thephantom8768/Phantom-Macro-Mk.1/README.md

# Phantom Macro Mk.1 Series

> A modular, snap-together macropad ecosystem with lateral pogo-pin bus interconnects.

Chain modules side-by-side to expand your desktop workflow—from a compact macro-pad into a full fledge keyboard.

---

## 📌 Project Status

- **Hardware:** Series still in-dev
- **Firmware:** In active development.
- **Interconnect:** Custom edge-mount 8 pin pogo interface.

---

## ⚡ Features

- **Snap & Chain Topology:** Expand your layout horizontally by mating adjacent modules using edge-mounted pogo connectors.
- **Unified Bus Standard:** Standardized power, ground, and communication rails allow any Mk.1-series compatible module to hot-mate with the system.
- **Flexible Layouts:** Mix and match different form factors (numpads, macro clusters, encoder dials) without rerunning separate USB cables to your host machine.

## ⚠️ Build Warnings

> **DIY Soldering Required:** This is a fully self-assembled project. It is not a plug-and-play kit and requires intermediate soldering experience.

* **Double-Sided Assembly:** Depending on the macro-pad, components might need to be soldered onto **both the top and bottom** of the PCB.

## *Mk.1 Series*

<details>
  <summary><b>🔢 Phantom-Macro-Mk.1 Pad (click here)</b></summary>
  
  ### Macro Mk.1 Pad
  
  #### Schematic

<table>
  <tr>
    <td colspan="4">
      Phantom Macro Mk1 Pad Schematic
    </td>
  </tr>
</table>

#### PCB Layout

4 Layers PCB
| Front (1st layer)|Back (4th layer) |
| ----- | ----- |
|  |  |

#### PCB
| Front | Back |
| ----- | ---- |
|  |  |
|  |  |

#### Case



</details>

<details>
  <summary><b>🎹 Phantom-Macro-Mk.1 MIDI (click here)</b></summary>
  
  ### Macro Mk.1 MIDI
  
  #### Schematic

  Phantom Macro Mk.1 MIDI

  ### PCB Layout 

  2 Layers PCB
  | Front | Back |
  | ----- | ----- |
  |  |  |

  #### PCB
  | Front | Back |
  | ----- | ---- |
  |  |  |
  |  |  |

</details>
