thephantom8768/Phantom-Macro-Mk.1/BOM.md

# Phantom Macro Mk.1 – bill of materials

<!-- Generated by Half Life from project cmuwyl8mx002001rlbmdwee1s. Edits here are overwritten on the next sync. -->
<!-- Generated: 2026-10-12T13:11:29.447Z -->

> [!NOTE]
> This parts list is mirrored from [Half Life](https://halflife.hackclub.com). Editing it here will not change the platform's copy, and the next sync overwrites this file.

| Week | Tier | Parts funding |
| --- | --- | --- |
| Week 1 | Tier 2 | $65.00 |

| Part | What it's for | Qty | Unit | Total | Vendor |
| --- | --- | --- | --- | --- | --- |
| [1uF](https://jlcpcb.com/partdetail/CL05A105KO5NNNC/C29266) | Capacitor | 20 | $0.01 | $0.20 | [JLCPCB](https://jlcpcb.com/partdetail/CL05A105KO5NNNC/C29266) |
| [15pF](https://jlcpcb.com/partdetail/KEMET-C0402C150J4GACTU/C2168202) | Capacitor | 3 | $0.01 | $0.03 | [JLCPCB](https://jlcpcb.com/partdetail/KEMET-C0402C150J4GACTU/C2168202) |
| [100nF](https://jlcpcb.com/partdetail/0402B104K250NT/C56392) | Capacitor | 9 | $0.01 | $0.09 | [JLCPCB](https://jlcpcb.com/partdetail/0402B104K250NT/C56392) |
| [USBLC6-2SC6](https://intl.taobao.com/sk/_b.rc54cg) | Protection | 1 | $0.02 | $0.02 | [Taobao](https://intl.taobao.com/sk/_b.rc54cg) |
| [PMEG3030EP](https://click.world.taobao.com/_b.Hc53SX 「A5 Silk Screen A5 Pmeg3030Ep Smd Sod-128 Schottky Diode Original in Stock Available for Direct Purchase」 Tap and open Taobao to view) | Diode | 1 | $0.01 | $0.01 | [Taobao](https://click.world.taobao.com/_b.Hc53SX 「A5 Silk Screen A5 Pmeg3030Ep Smd Sod-128 Schottky Diode Original in Stock Available for Direct Purchase」 Tap and open Taobao to view) |
| [USB_C_Receptacle_USB2.0_16P](https://intl.taobao.com/sk/_b.zc53Cc 「10 Pieces) Ul26 Ul46 Smd Sot23-6 Esd Electrostatic Protection Component Usblc6-2Sc6/4Sc6」 Tap and open Taobao to view) | USB C | 1 | $0.03 | $0.03 | [Taobao](https://intl.taobao.com/sk/_b.zc53Cc 「10 Pieces) Ul26 Ul46 Smd Sot23-6 Esd Electrostatic Protection Component Usblc6-2Sc6/4Sc6」 Tap and open Taobao to view) |
| [01x08 pogo](https://intl.taobao.com/sk/_b.oc53e2) | Connect other macropads | 1 | $1.64 | $1.64 | [Taobao](https://intl.taobao.com/sk/_b.oc53e2) |
| [SK6803MINI-E-001](https://intl.taobao.com/sk/_b.Rc54Br781-83e92ad56c50&pdp_ext_f=%7B%22order%22%3A%2264%22%2C%22eval%22%3A%221%22%2C%22fromPage%22%3A%22search%22%7D&utparam-url=scene%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) | RGB | 16 | $0.05 | $0.80 | [Taobao](https://intl.taobao.com/sk/_b.Rc54Br781-83e92ad56c50&pdp_ext_f=%7B%22order%22%3A%2264%22%2C%22eval%22%3A%221%22%2C%22fromPage%22%3A%22search%22%7D&utparam-url=scene%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) |
| [2N7002 7002 (per lot)](https://intl.taobao.com/sk/_b.Mc53Sz) | MOSFET | 1 | $0.27 | $0.27 | [Taobao](https://intl.taobao.com/sk/_b.Mc53Sz) |
| [5.1k](https://jlcpcb.com) | Resistor | 2 | $0.01 | $0.02 | [JLCPCB](https://jlcpcb.com) |
| [1k](https://jlcpcb.com) | Res | 1 | $0.01 | $0.01 | [JLCPCB](https://jlcpcb.com) |
| [10k](https://jlcpcb.com) | Resistor | 2 | $0.01 | $0.02 | [JLCPCB](https://jlcpcb.com) |
| [120R](https://jlcpcb.com) | Resistor | 2 | $0.01 | $0.02 | [JLCPCB](https://jlcpcb.com) |
| [PEC11R-4020F-S0024](https://intl.taobao.com/sk/_b.Rc53Te) | Rotary encoder | 1 | $3.49 | $3.49 | [Taobao](https://intl.taobao.com/sk/_b.Rc53Te) |
| [ABM8-272-T3_C20625731](https://intl.taobao.com/sk/_b.Pc54b5) | Crystal clock | 1 | $0.07 | $0.07 | [Taobao](https://intl.taobao.com/sk/_b.Pc54b5) |
| [CD74HC4067SM96](https://intl.taobao.com/sk/_b.Cc540g) | Multiplexer | 2 | $0.43 | $0.86 | [Taobao](https://intl.taobao.com/sk/_b.Cc540g) |
| [SW_MX_HE (per lot)](https://milktooth.com/products/dove-he) | Haimu Dove HE v2 switches | 2 | $6.79 | $13.58 | [Milktooth](https://milktooth.com/products/dove-he) |
| [RP2040](https://intl.taobao.com/sk/_b.Ec533r) | MCU | 1 | $0.40 | $0.40 | [Taobao](https://intl.taobao.com/sk/_b.Ec533r) |
| [PCA9615DPZ / PCA9614DPZ](https://intl.taobao.com/sk/_b.Tc53GCam-url=scene%3Asearch%7Cquery_from%3A%7Cx_object_id%3A1005010726241692%7C_p_origin_prod%3A) | dI2c | 2 | $2.32 | $4.64 | [Taobao](https://intl.taobao.com/sk/_b.Tc53GCam-url=scene%3Asearch%7Cquery_from%3A%7Cx_object_id%3A1005010726241692%7C_p_origin_prod%3A) |
| [AP2112K-3.3TRG1](https://intl.taobao.com/sk/_b.uc542n) | 3V3 | 1 | $0.04 | $0.04 | [Taobao](https://intl.taobao.com/sk/_b.uc542n) |
| [W25Q128JVSIQ](https://intl.taobao.com/sk/_b.0c54pc6-7a44a45a75ad&pdp_ext_f=%7B%22order%22%3A%22-1%22%2C%22eval%22%3A%221%22%2C%22fromPage%22%3A%22search%22%7D&utparam-url=scene%3A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) | RP2040 Flash | 1 | $0.47 | $0.47 | [Taobao](https://intl.taobao.com/sk/_b.0c54pc6-7a44a45a75ad&pdp_ext_f=%7B%22order%22%3A%22-1%22%2C%22eval%22%3A%221%22%2C%22fromPage%22%3A%22search%22%7D&utparam-url=scene%3A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) |
| [PCB](https://jlcpcb.com) | Pcb | 1 | $31.10 | $31.10 | [JLCPCB](https://jlcpcb.com) |
| [DRV5055A3QDBZR (10 per lot)](https://intl.taobao.com/sk/_b.Qc5rRz) | Hall effect sensor | 2 | $3.10 | $6.20 | [Taobao](https://intl.taobao.com/sk/_b.Qc5rRz) |
| **Parts subtotal** | — | — | — | **$64.01** | — |
| **Tax & shipping** | — | — | — | **$0.00** | — |
| **Total** | — | — | — | **$64.01** | — |

$0.99 left of the tier's funding.
