thephantom8768/Phantom-Macro-Mk.1/BOM.csv

Reference | Qty | Value | DNP | Exclude from BOM | Exclude from Board | Footprint | Datasheet
C1,C2,C6,C7,C17,C18,C19,C21,C22,C23,C24,C25,C26,C27,C28,C29,C30,C31,C32,C33 | 20 | 1uF |  |  |  | Capacitor_SMD:C_0603_1608Metric_Pad1.08x0.95mm_HandSolder
C3,C4,C5 | 3 | 15pF |  |  |  | Capacitor_SMD:C_0402_1005Metric_Pad0.74x0.62mm_HandSolder
C8,C9,C10,C11,C12,C13,C14,C15,C16 | 9 | 100nF |  |  |  | Capacitor_SMD:C_0402_1005Metric_Pad0.74x0.62mm_HandSolder
D1 | 1 | USBLC6-2SC6 |  |  |  | PCM_Package_TO_SOT_SMD_AKL:SOT-23-6 | https://www.tme.eu/Document/db59d28d28a96c34f26d05f234ff409c/USBLC6-2.pdf
D2 | 1 | PMEG3030EP |  |  |  | PCM_Diode_SMD_AKL:D_SOD-128 | https://www.tme.eu/Document/abe71b1e3ae43c8e032df0d278a6f86a/PMEG3030EP.115.pdf
J1 | 1 | USB_C_Receptacle_USB2.0_16P |  |  |  | Connector_USB:USB_C_Receptacle_GCT_USB4110 | https://www.usb.org/sites/default/files/documents/usb_type-c.zip
J2 | 1 | Conn_01x02 |  |  |  | Connector_PinSocket_2.54mm:PinSocket_1x02_P2.54mm_Vertical
J4,J5 | 2 | Conn_01x08 |  |  |  | Connector_PinHeader_2.54mm:PinHeader_1x08_P2.54mm_Horizontal
LED1,LED2,LED3,LED5,LED6,LED7,LED8,LED9,LED10,LED11,LED12,LED13,LED14,LED15,LED16,LED17 | 16 | SK6803MINI-E-001 |  |  |  | lcsc_shared_footprints:C5242955_LED-SMD_4P-L3_2-W2_8_SK6803MINI-E-001 | https://wmsc.lcsc.com/wmsc/upload/file/pdf/v2/lcsc/2211011500_OPSCO-Optoelectronics-SK6803MINI-E-001_C5242955.pdf
Q1,Q2 | 2 | 2N7002 7002 |  |  |  | lcsc_shared_footprints:C8545_SOT-23-3_L2_9-W1_3-P1_90-LS2_4-BR | https://www.lcsc.com/datasheet/lcsc_datasheet_2304140030_Jiangsu-Changjing-Electronics-Technology-Co---Ltd--2N7002_C8545.pdf
R1,R2 | 2 | 5.1k |  |  |  | Resistor_SMD:R_0402_1005Metric_Pad0.72x0.64mm_HandSolder
R3 | 1 | 1k |  |  |  | Resistor_SMD:R_0402_1005Metric_Pad0.72x0.64mm_HandSolder
R4,R5 | 2 | 10k |  |  |  | Resistor_SMD:R_0402_1005Metric_Pad0.72x0.64mm_HandSolder
R6,R7 | 2 | 120R |  |  |  | Resistor_SMD:R_0402_1005Metric_Pad0.72x0.64mm_HandSolder
SW1 | 1 | PEC11R-4020F-S0024 |  |  |  | lcsc_shared_footprints:C143788_SW-TH_5P-L12_5-W13_4-P2_50-LS14_5 | https://www.lcsc.com/datasheet/lcsc_datasheet_2304140030_BOURNS-PEC11R-4020F-S0024_C143788.pdf
U1 | 1 | ABM8-272-T3_C20625731 |  |  |  | lcsc_shared_footprints:C20625731_CRYSTAL-SMD_4P-L3_2-W2_5-BL | https://www.lcsc.com/datasheet/lcsc_datasheet_2410121909_Abracon-LLC-ABM8-272-T3_C20625731.pdf
U2,U22 | 2 | CD74HC4067SM96 |  |  |  | lcsc_shared_footprints:C98457_SSOP-24_L8_1-W5_3-P0_65-LS7_8-BL | https://www.lcsc.com/datasheet/lcsc_datasheet_1810010611_Texas-Instruments-CD74HC4067SM96_C98457.pdf
U3,U4,U5,U7,U8,U9,U10,U11,U12,U13,U14,U15,U16,U17,U18,U19 | 16 | SW_MX_HE |  |  |  | PCM_marbastlib-he:Haimu Dove H V2 | https://wmsc.lcsc.com/wmsc/upload/file/pdf/v2/lcsc/2310271810_Hallwee-HAL9303SO_C19089525.pdf
U6 | 1 | RP2040 |  |  |  | lcsc_shared_footprints:C2040_LQFN-56_L7_0-W7_0-P0_4-EP | https://www.lcsc.com/datasheet/lcsc_datasheet_2201101600_Raspberry-Pi-RP2040_C2040.pdf
U20,U23 | 2 | PCA9615DPZ |  |  |  | lcsc_shared_footprints:C3824272_TSSOP-10_L3_0-W3_0-P0_50-LS4_9-BL | https://wmsc.lcsc.com/wmsc/upload/file/pdf/v2/lcsc/2407081642_NXP-Semicon-PCA9615DPZ_C3824272.pdf
U21 | 1 | AP2112K-3.3TRG1 |  |  |  | lcsc_shared_footprints:C51118_SOT-25-5_L2_9-W1_6-P0_95-LS2_8-BL | https://www.lcsc.com/datasheet/lcsc_datasheet_2304140030_Diodes-Incorporated-AP2112K-3-3TRG1_C51118.pdf
U25 | 1 | W25Q128JVSIQ |  |  |  | lcsc_shared_footprints:C113767_SOIC-8_L5_3-W5_3-P1_27-LS8_0-BL | https://www.lcsc.com/datasheet/lcsc_datasheet_1912111437_Winbond-Elec-W25Q128JVSIQ_C113767.pdf
