thephantom8768/Phantom-Macro-Mk.1/3D Case and Freecad File/Phantom Macro Mk1 Pad.step

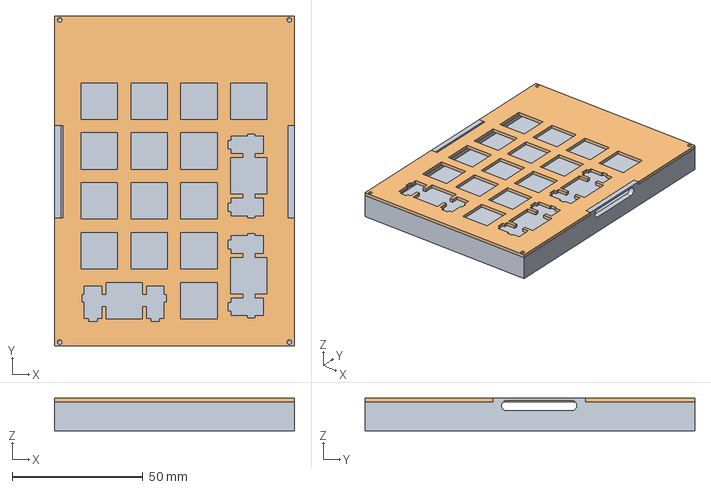
[picture p1: CAD file, 2026-10-19]
3D Case and Freecad File/Phantom Macro Mk1 Pad.step
91.7 x 126.1 x 12.5 mm
Mounting_plate
