thephantom8768/Phantom-Macro-Mk.1/(list of files, cad)

Other CAD files:
3D Case and Freecad File/Phantom Macro Mk1 Pad.FCStd
3D Case and Freecad File/Phantom Macro Mk1 Pad.stl
