thephantom8768/Phantom-Macro-Mk.1/Phantom Macro Mk1 Pad Kicad source file/Kicad file/Phantom Macro Mk1 Pad.kicad_pcb

## KiCad design Phantom Macro Mk1 Pad Kicad source file/Kicad file/Phantom Macro Mk1 Pad.kicad_pcb (2026-10-16)

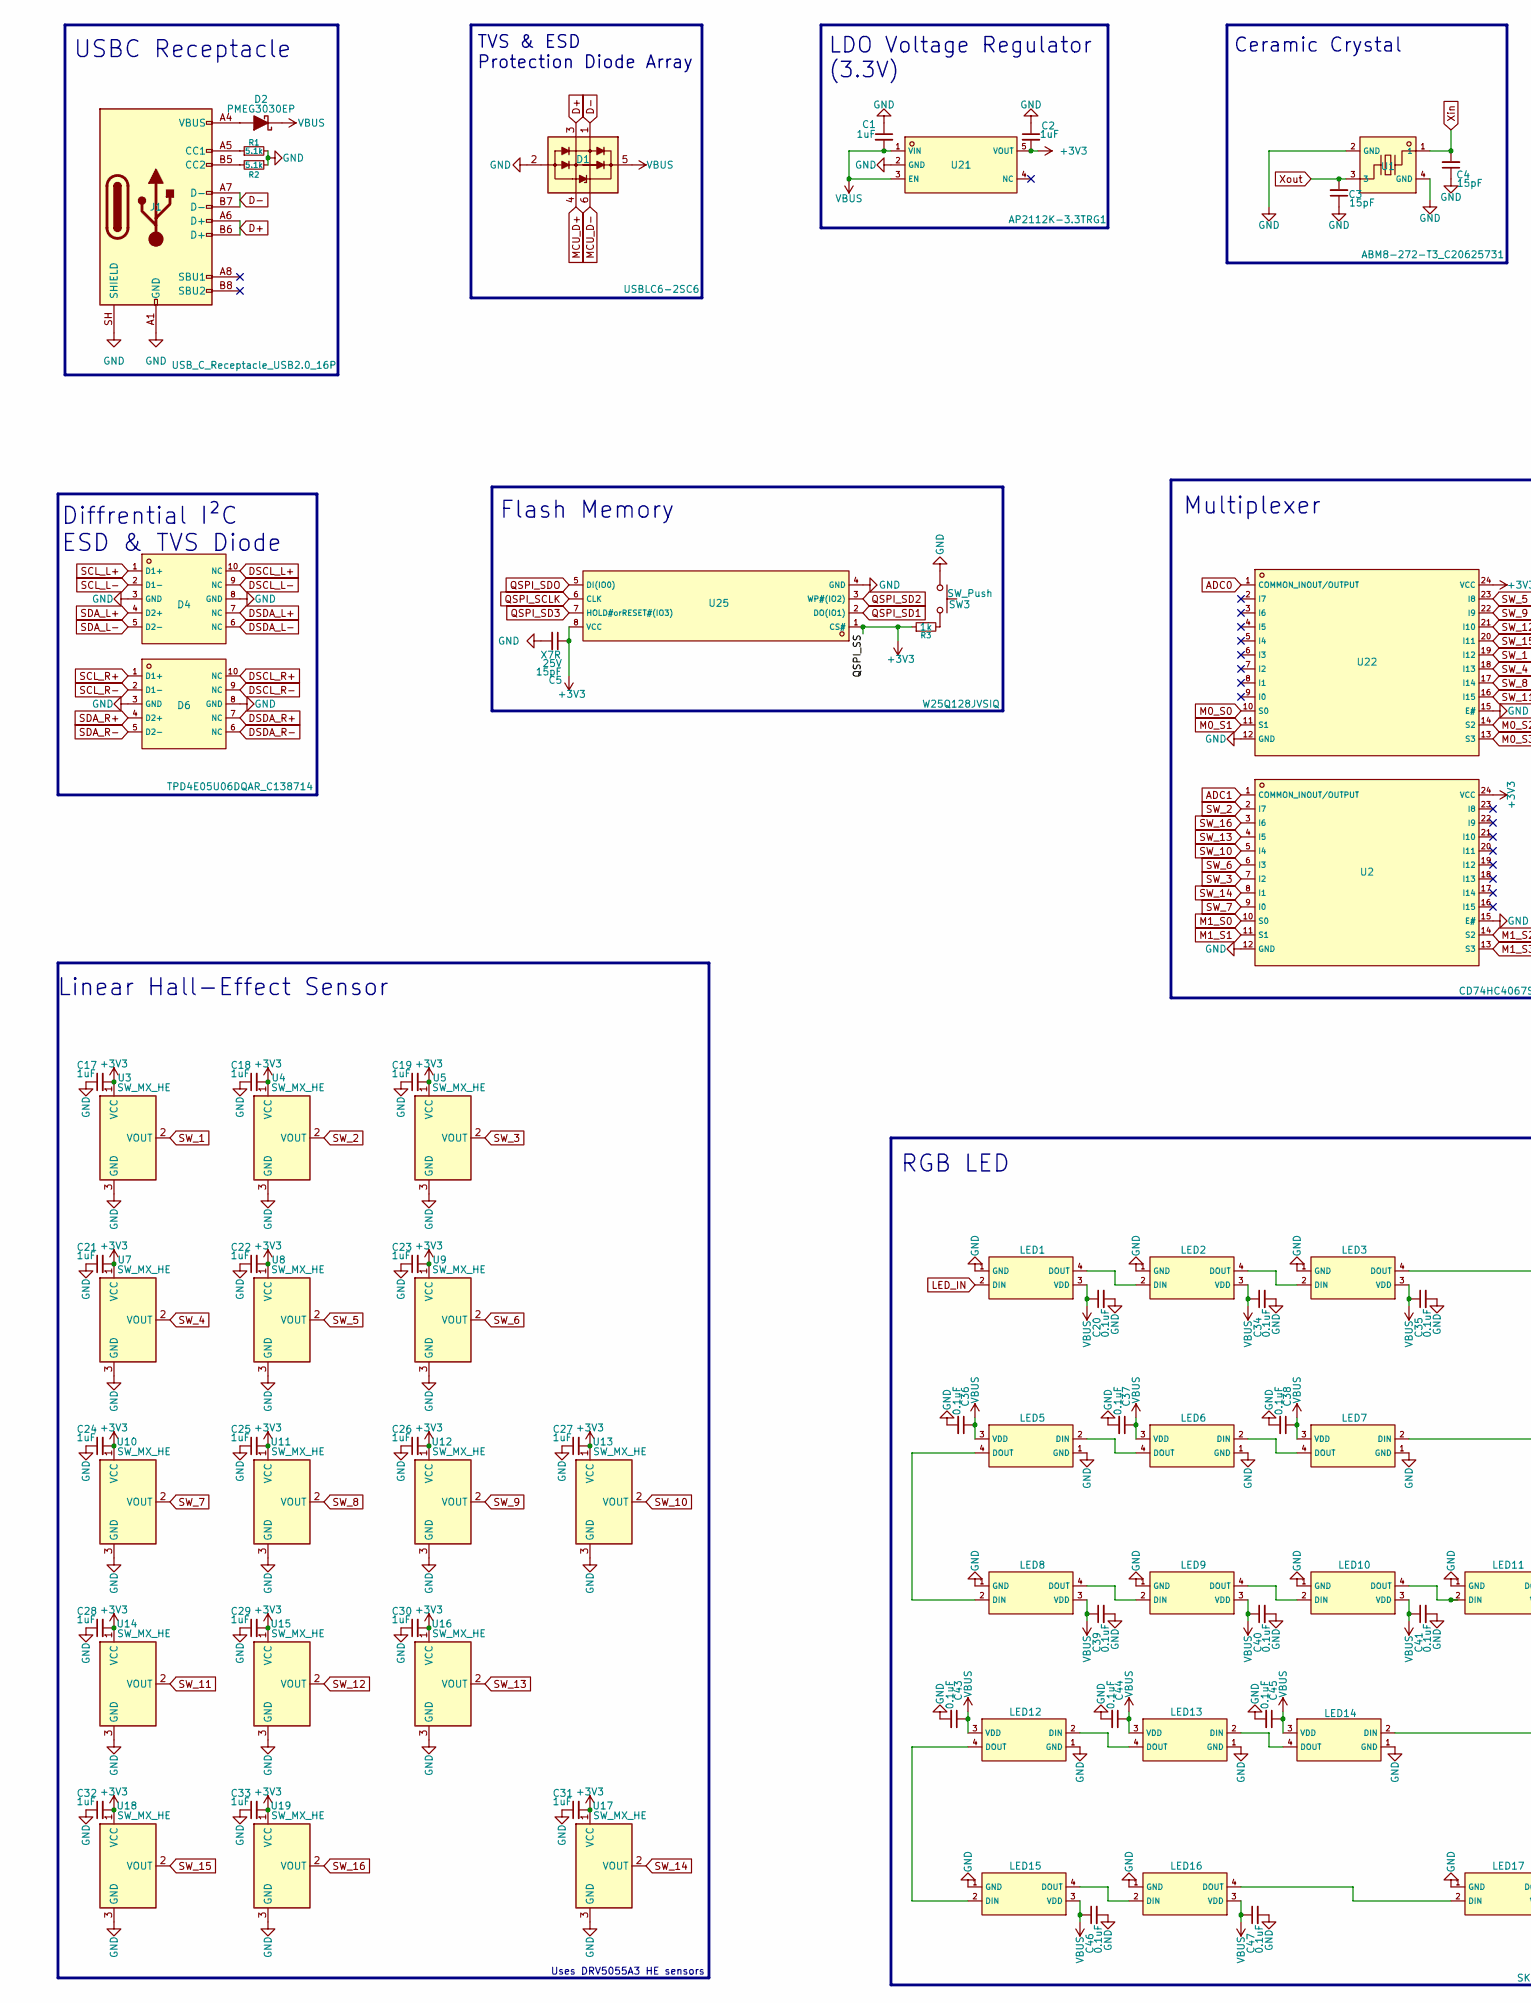
[picture p2: schematic Phantom Macro Mk1 Pad.kicad_sch, part in row 1, column 1]

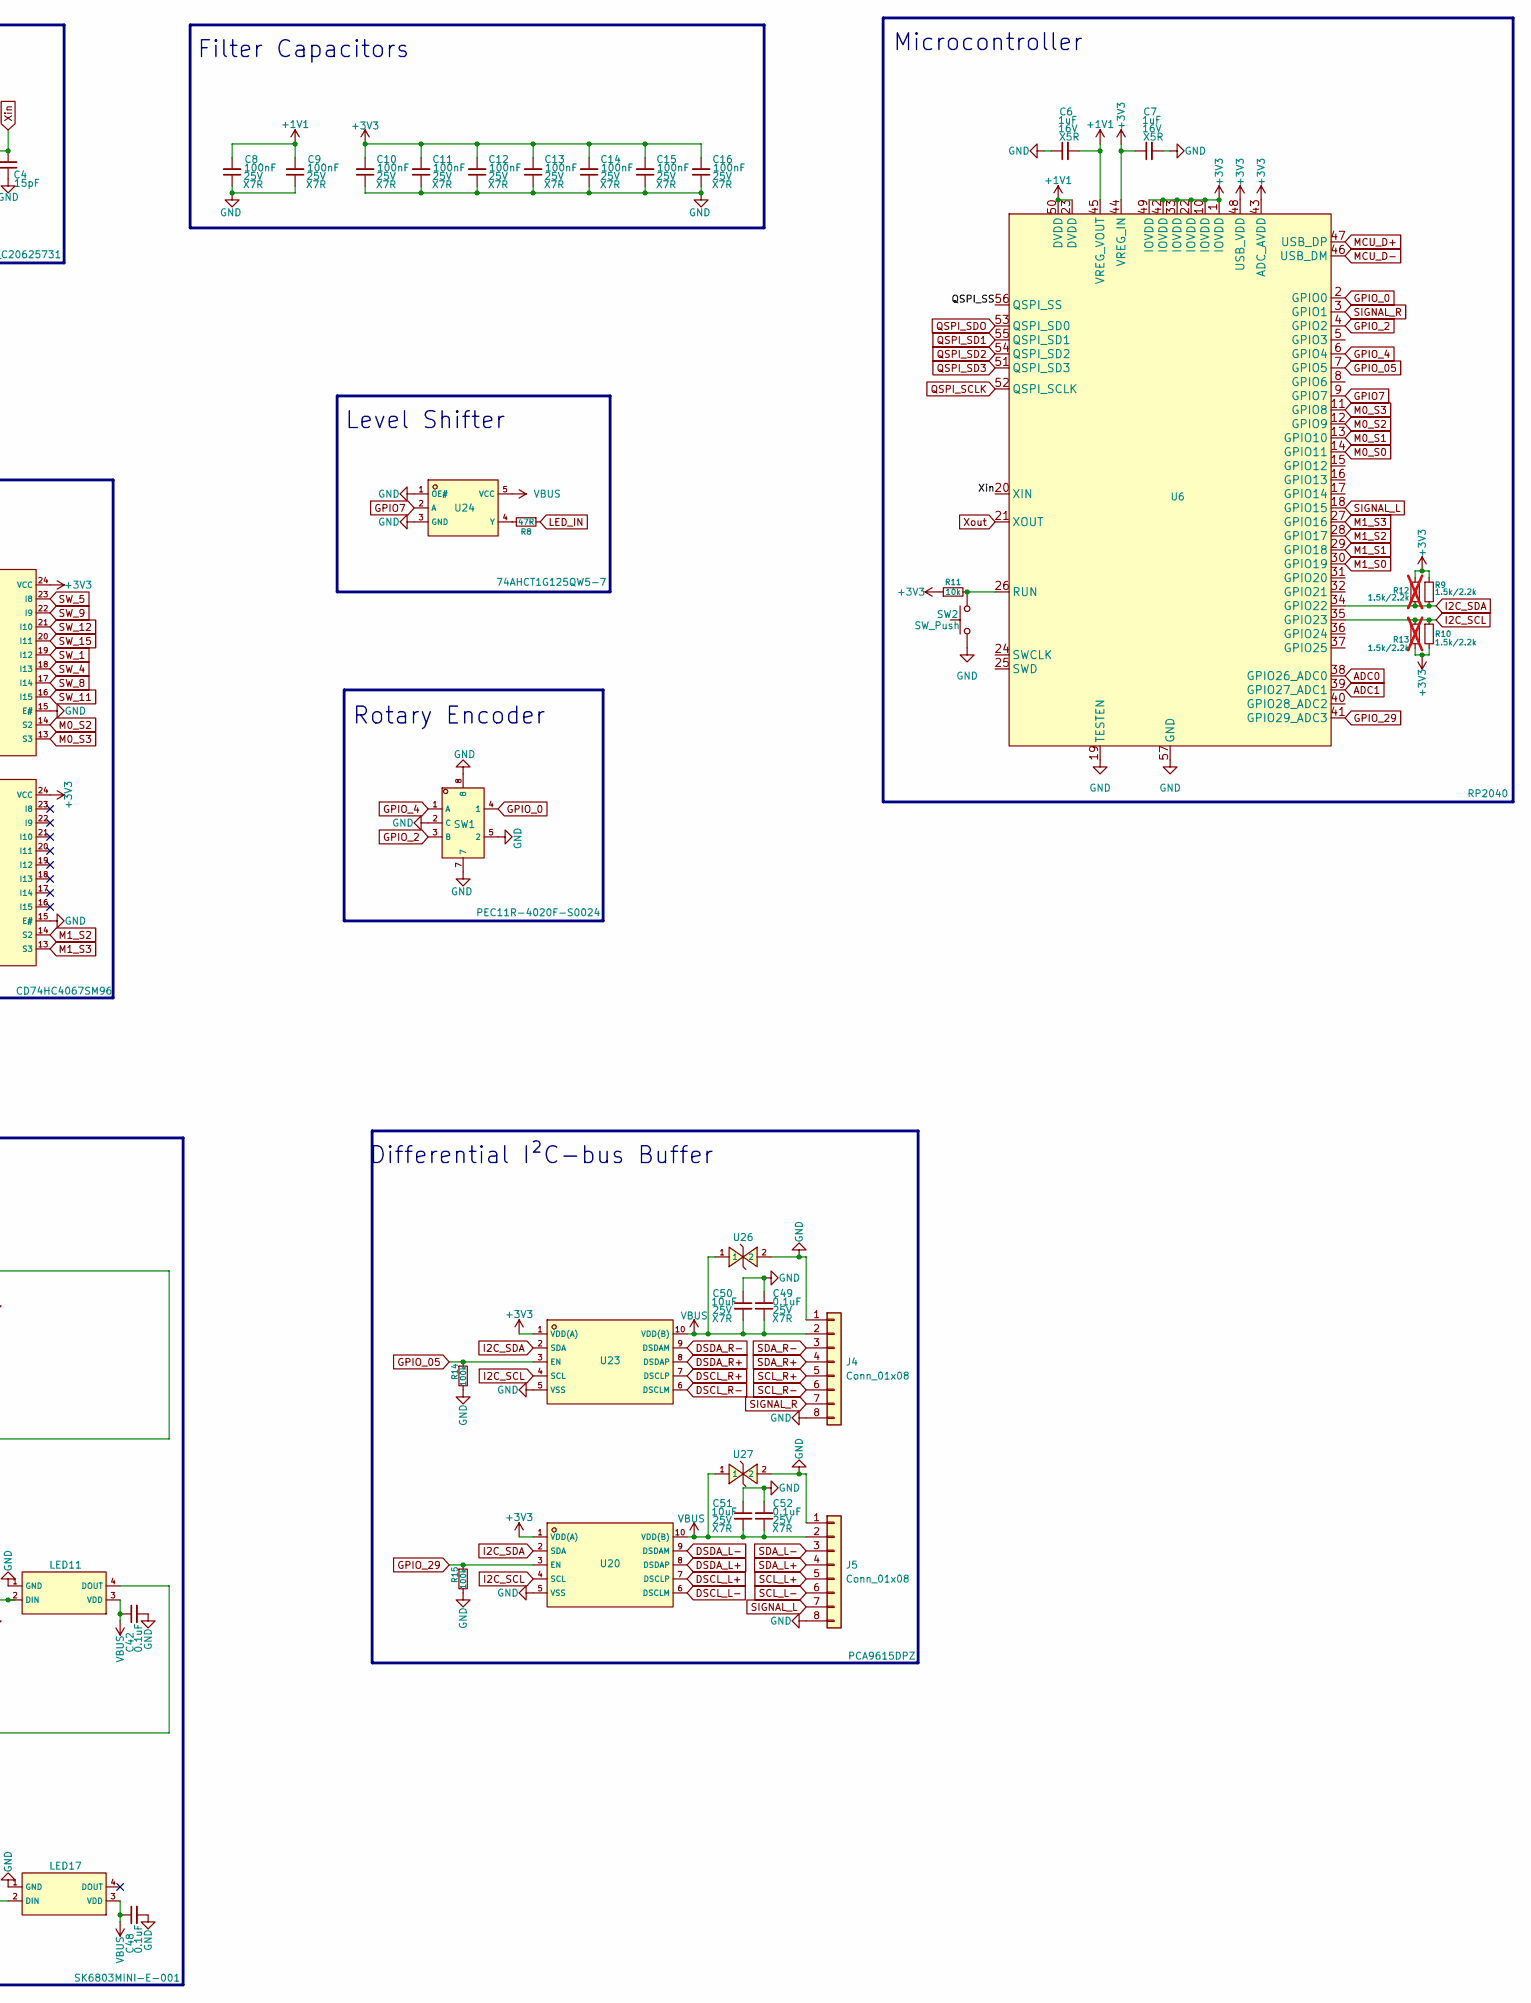
[picture p3: schematic Phantom Macro Mk1 Pad.kicad_sch, part in row 1, column 2]

Parts:
C1, C2, C17, C18, C19, C21, C22, C23, C24, C25, C26, C27, C28, C29, C30, C31, C32, C33: 1uF; C_0603_1608Metric_Pad1.08x0.95mm_HandSolder
C3, C4: 15pF; C_0402_1005Metric_Pad0.74x0.62mm_HandSolder
C5: 15pF; C_0402_1005Metric_Pad0.74x0.62mm_HandSolder; Rating 25V
C6, C7: 1uF; C_0603_1608Metric_Pad1.08x0.95mm_HandSolder; Rating 16V
C8, C9, C10, C11, C12, C13, C14, C15, C16: 100nF; C_0402_1005Metric_Pad0.74x0.62mm_HandSolder; Rating 25V
C20, C34, C35, C36, C37, C38, C39, C40, C41, C42, C43, C44, C45, C46, C47, C48: 0.1uF; C_0603_1608Metric_Pad1.08x0.95mm_HandSolder
C49, C52: 0.1uF; C_0805_2012Metric_Pad1.18x1.45mm_HandSolder; Rating 25V
C50, C51: 10uF; C_0805_2012Metric_Pad1.18x1.45mm_HandSolder; Rating 25V
D1: USBLC6-2SC6; SOT-23-6
D2: PMEG3030EP; D_SOD-128
D4, D6: TPD4E05U06DQAR_C138714; C138714_USON-10_L2_5-W1_0-P0_50-BL; LCSC C138714
J1: USB_C_Receptacle_USB2.0_16P; USB_C_Receptacle_GCT_USB4110
J4, J5: Conn_01x08; PinHeader_1x08_P2.54mm_Horizontal
LED1, LED2, LED3, LED5, LED6, LED7, LED8, LED9, LED10, LED11, LED12, LED13, LED14, LED15, LED16, LED17: SK6803MINI-E-001; C5242955_LED-SMD_4P-L3_2-W2_8_SK6803MINI-E-001; LCSC C5242955
R1, R2: 5.1k; R_0402_1005Metric_Pad0.72x0.64mm_HandSolder
R3: 1k; R_0402_1005Metric_Pad0.72x0.64mm_HandSolder
R8: 47R; R_0402_1005Metric_Pad0.72x0.64mm_HandSolder
R9, R10: 1.5k/2.2k; R_0402_1005Metric_Pad0.72x0.64mm_HandSolder
R11: 10k; R_0402_1005Metric_Pad0.72x0.64mm_HandSolder
R12, R13: 1.5k/2.2k; R_0402_1005Metric_Pad0.72x0.64mm_HandSolder; not fitted
R14, R15: 100k; R_0402_1005Metric_Pad0.72x0.64mm_HandSolder
SW1: PEC11R-4020F-S0024; C143788_SW-TH_5P-L12_5-W13_4-P2_50-LS14_5; LCSC C143788
SW2, SW3: SW_Push; SW_SPST_B3U-1000P
U1: ABM8-272-T3_C20625731; C20625731_CRYSTAL-SMD_4P-L3_2-W2_5-BL; LCSC C20625731
U2, U22: CD74HC4067SM96; C98457_SSOP-24_L8_1-W5_3-P0_65-LS7_8-BL; LCSC C98457
U3, U4, U5, U7, U8, U9, U10, U11, U12, U13, U14, U15, U16, U17, U18, U19: SW_MX_HE; Haimu Dove H V2
U6: RP2040; C2040_LQFN-56_L7_0-W7_0-P0_4-EP; LCSC C2040
U20, U23: PCA9615DPZ; C3824272_TSSOP-10_L3_0-W3_0-P0_50-LS4_9-BL; LCSC C3824272
U21: AP2112K-3.3TRG1; C51118_SOT-25-5_L2_9-W1_6-P0_95-LS2_8-BL; LCSC C51118
U24: 74AHCT1G125QW5-7; C3755013_SOT-753_L3_1-W1_7-P0_95-LS3_0-BR; LCSC C3755013
U25: W25Q128JVSIQ; C113767_SOIC-8_L5_3-W5_3-P1_27-LS8_0-BL; LCSC C113767
U26, U27: TPD1E10B06DPYR; C48260_X1SON-2_L1_0-W0_6-P0_65-BI-1; LCSC C48260

Connections:
+1V1: C6.2, C8.2, C9.2, U6.23 (DVDD), U6.45 (VREG_VOUT), U6.50 (DVDD)
+3V3: C2.2, C5.1, C7.1, C10.2, C11.2, C12.2, C13.2, C14.2, C15.2, C16.2, C17.2, C18.2, C19.2, C21.2, C22.2, C23.2, C24.2, C25.2, C26.2, C27.2, C28.2, C29.2, C30.2, C31.2, C32.2, C33.2, R3.1, R9.1, R10.2, R11.1, R12.1, R13.2, U2.24 (VCC), U3.1 (VCC), U4.1 (VCC), U5.1 (VCC), U6.1 (IOVDD), U6.10 (IOVDD), U6.22 (IOVDD), U6.33 (IOVDD), U6.42 (IOVDD), U6.43 (ADC_AVDD), U6.44 (VREG_IN), U6.48 (USB_VDD), U6.49 (IOVDD), U6.56 (QSPI_SS), U7.1 (VCC), U8.1 (VCC), U9.1 (VCC), U10.1 (VCC), U11.1 (VCC), U12.1 (VCC), U13.1 (VCC), U14.1 (VCC), U15.1 (VCC), U16.1 (VCC), U17.1 (VCC), U18.1 (VCC), U19.1 (VCC), U20.1 (VDD(A)), U21.5 (VOUT), U22.24 (VCC), U23.1 (VDD(A)), U25.1 (CS#), U25.8 (VCC)
ADC0: U6.38 (GPIO26_ADC0), U22.1 (COMMON_INOUT/OUTPUT)
ADC1: U2.1 (COMMON_INOUT/OUTPUT), U6.39 (GPIO27_ADC1)
D+: D1.3 (L2), J1.A6 (D+), J1.B6 (D+)
D-: D1.1 (L1), J1.A7 (D-), J1.B7 (D-)
DSCL_L+: D4.10 (NC), U20.7 (DSCLP)
DSCL_L-: D4.9 (NC), U20.6 (DSCLM)
DSCL_R+: D6.10 (NC), U23.7 (DSCLP)
DSCL_R-: D6.9 (NC), U23.6 (DSCLM)
DSDA_L+: D4.7 (NC), U20.8 (DSDAP)
DSDA_L-: D4.6 (NC), U20.9 (DSDAM)
DSDA_R+: D6.7 (NC), U23.8 (DSDAP)
DSDA_R-: D6.6 (NC), U23.9 (DSDAM)
GND: C1.1, C2.1, C3.1, C4.1, C5.2, C6.1, C7.2, C8.1, C9.1, C10.1, C11.1, C12.1, C13.1, C14.1, C15.1, C16.1, C17.1, C18.1, C19.1, C20.2, C21.1, C22.1, C23.1, C24.1, C25.1, C26.1, C27.1, C28.1, C29.1, C30.1, C31.1, C32.1, C33.1, C34.2, C35.2, C36.2, C37.2, C38.2, C39.2, C40.2, C41.2, C42.2, C43.2, C44.2, C45.2, C46.2, C47.2, C48.2, C49.2, C50.1, C51.1, C52.2, D1.2 (VN), D4.3 (GND), D4.8 (GND), D6.3 (GND), D6.8 (GND), J1.A1 (GND), J1.A12 (GND), J1.B1 (GND), J1.B12 (GND), J1.SH (SHIELD), J4.1, J4.8, J5.1, J5.8, LED1.1 (GND), LED2.1 (GND), LED3.1 (GND), LED5.1 (GND), LED6.1 (GND), LED7.1 (GND), LED8.1 (GND), LED9.1 (GND), LED10.1 (GND), LED11.1 (GND), LED12.1 (GND), LED13.1 (GND), LED14.1 (GND), LED15.1 (GND), LED16.1 (GND), LED17.1 (GND), R1.2, R2.1, R14.2, R15.2, SW1.2 (C), SW1.5 (2), SW1.7, SW1.8, SW2.1, SW3.1, U1.2 (GND), U1.4 (GND), U2.12 (GND), U2.15 (E#), U3.3 (GND), U4.3 (GND), U5.3 (GND), U6.19 (TESTEN), U6.57 (GND), U7.3 (GND), U8.3 (GND), U9.3 (GND), U10.3 (GND), U11.3 (GND), U12.3 (GND), U13.3 (GND), U14.3 (GND), U15.3 (GND), U16.3 (GND), U17.3 (GND), U18.3 (GND), U19.3 (GND), U20.5 (VSS), U21.2 (GND), U22.12 (GND), U22.15 (E#), U23.5 (VSS), U24.1 (OE#), U24.3 (GND), U25.4 (GND), U26.2, U27.2
GPIO7: U6.9 (GPIO7), U24.2 (A)
GPIO_0: SW1.4 (1), U6.2 (GPIO0)
GPIO_2: SW1.3 (B), U6.4 (GPIO2)
GPIO_4: SW1.1 (A), U6.6 (GPIO4)
GPIO_05: R14.1, U6.7 (GPIO5), U23.3 (EN)
GPIO_29: R15.1, U6.41 (GPIO29_ADC3), U20.3 (EN)
I2C_SCL: R10.1, R13.1, U6.35 (GPIO23), U20.4 (SCL), U23.4 (SCL)
I2C_SDA: R9.2, R12.2, U6.34 (GPIO22), U20.2 (SDA), U23.2 (SDA)
LED_IN: LED1.2 (DIN), R8.1
M0_S0: U6.14 (GPIO11), U22.10 (S0)
M0_S1: U6.13 (GPIO10), U22.11 (S1)
M0_S2: U6.12 (GPIO9), U22.14 (S2)
M0_S3: U6.11 (GPIO8), U22.13 (S3)
M1_S0: U2.10 (S0), U6.30 (GPIO19)
M1_S1: U2.11 (S1), U6.29 (GPIO18)
M1_S2: U2.14 (S2), U6.28 (GPIO17)
M1_S3: U2.13 (S3), U6.27 (GPIO16)
MCU_D+: D1.4 (L2), U6.47 (USB_DP)
MCU_D-: D1.6 (L1), U6.46 (USB_DM)
unnamed: D2.2 (A), J1.A4 (VBUS), J1.A9 (VBUS), J1.B4 (VBUS), J1.B9 (VBUS)
unnamed: J1.A5 (CC1), R1.1
unnamed: J1.B5 (CC2), R2.2
unnamed: LED1.4 (DOUT), LED2.2 (DIN)
unnamed: LED2.4 (DOUT), LED3.2 (DIN)
unnamed: LED3.4 (DOUT), LED7.2 (DIN)
unnamed: LED5.2 (DIN), LED6.4 (DOUT)
unnamed: LED5.4 (DOUT), LED8.2 (DIN)
unnamed: LED6.2 (DIN), LED7.4 (DOUT)
unnamed: LED8.4 (DOUT), LED9.2 (DIN)
unnamed: LED9.4 (DOUT), LED10.2 (DIN)
unnamed: LED10.4 (DOUT), LED11.2 (DIN)
unnamed: LED11.4 (DOUT), LED14.2 (DIN)
unnamed: LED12.2 (DIN), LED13.4 (DOUT)
unnamed: LED12.4 (DOUT), LED15.2 (DIN)
unnamed: LED13.2 (DIN), LED14.4 (DOUT)
unnamed: LED15.4 (DOUT), LED16.2 (DIN)
unnamed: LED16.4 (DOUT), LED17.2 (DIN)
unnamed: R3.2, SW3.2
unnamed: R11.2, SW2.2, U6.26 (RUN)
unnamed: R8.2, U24.4 (Y)
QSPI_SCLK: U6.52 (QSPI_SCLK), U25.6 (CLK)
QSPI_SD1: U6.55 (QSPI_SD1), U25.2 (DO(IO1))
QSPI_SD2: U6.54 (QSPI_SD2), U25.3 (WP#(IO2))
QSPI_SD3: U6.51 (QSPI_SD3), U25.7 (HOLD#orRESET#(IO3))
QSPI_SDO: U6.53 (QSPI_SD0), U25.5 (DI(IO0))
SCL_L+: D4.1 (D1+), J5.5
SCL_L-: D4.2 (D1-), J5.6
SCL_R+: D6.1 (D1+), J4.5
SCL_R-: D6.2 (D1-), J4.6
SDA_L+: D4.4 (D2+), J5.4
SDA_L-: D4.5 (D2-), J5.3
SDA_R+: D6.4 (D2+), J4.4
SDA_R-: D6.5 (D2-), J4.3
SIGNAL_L: J5.7, U6.18 (GPIO15)
SIGNAL_R: J4.7, U6.3 (GPIO1)
SW_1: U3.2 (VOUT), U22.19 (I12)
SW_2: U2.2 (I7), U4.2 (VOUT)
SW_3: U2.7 (I2), U5.2 (VOUT)
SW_4: U7.2 (VOUT), U22.18 (I13)
SW_5: U8.2 (VOUT), U22.23 (I8)
SW_6: U2.6 (I3), U9.2 (VOUT)
SW_7: U2.9 (I0), U10.2 (VOUT)
SW_8: U11.2 (VOUT), U22.17 (I14)
SW_9: U12.2 (VOUT), U22.22 (I9)
SW_10: U2.5 (I4), U13.2 (VOUT)
SW_11: U14.2 (VOUT), U22.16 (I15)
SW_12: U15.2 (VOUT), U22.21 (I10)
SW_13: U2.4 (I5), U16.2 (VOUT)
SW_14: U2.8 (I1), U17.2 (VOUT)
SW_15: U18.2 (VOUT), U22.20 (I11)
SW_16: U2.3 (I6), U19.2 (VOUT)
VBUS: C1.2, C20.1, C34.1, C35.1, C36.1, C37.1, C38.1, C39.1, C40.1, C41.1, C42.1, C43.1, C44.1, C45.1, C46.1, C47.1, C48.1, C49.1, C50.2, C51.2, C52.1, D1.5 (VP), D2.1 (K), J4.2, J5.2, LED1.3 (VDD), LED2.3 (VDD), LED3.3 (VDD), LED5.3 (VDD), LED6.3 (VDD), LED7.3 (VDD), LED8.3 (VDD), LED9.3 (VDD), LED10.3 (VDD), LED11.3 (VDD), LED12.3 (VDD), LED13.3 (VDD), LED14.3 (VDD), LED15.3 (VDD), LED16.3 (VDD), LED17.3 (VDD), U20.10 (VDD(B)), U21.1 (VIN), U21.3 (EN), U23.10 (VDD(B)), U24.5 (VCC), U26.1, U27.1
Xin: C4.2, U1.1, U6.20 (XIN)
Xout: C3.2, U1.3, U6.21 (XOUT)

Notes on the sheet:
LDO Voltage Regulator (3.3V)
RGB LED
Flash Memory
Multiplexer
Filter Capacitors
Ceramic Crystal
Level Shifter
Rotary Encoder
TVS & ESD Protection Diode Array
Uses DRV5055A3 HE sensors
Microcontroller
Linear Hall-Effect Sensor
Differential I²C-bus Buffer
Diffrential I²C ESD & TVS Diode
USBC Receptacle

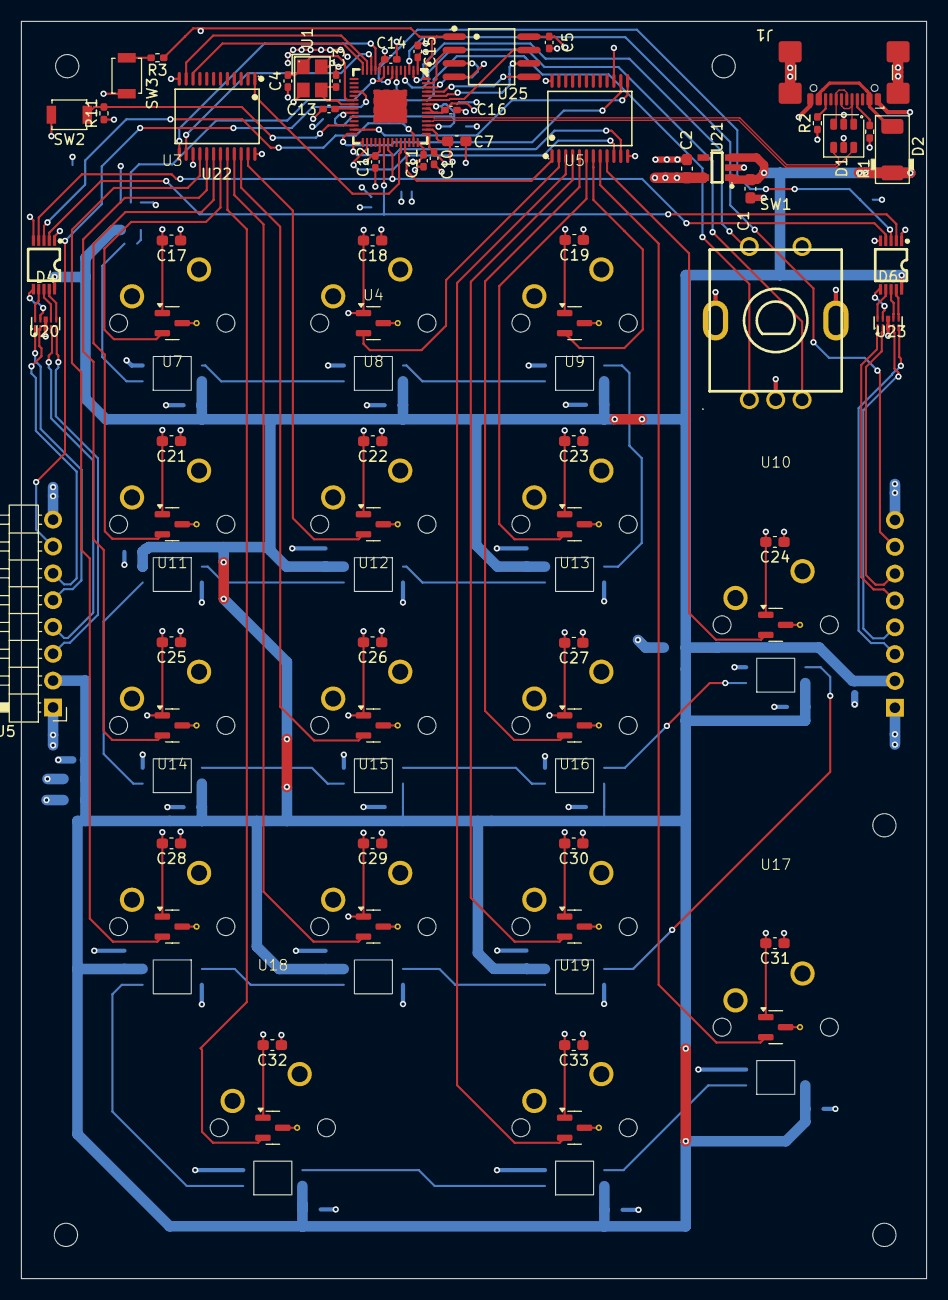
[picture p4: board Phantom Macro Mk1 Pad.kicad_pcb from above]

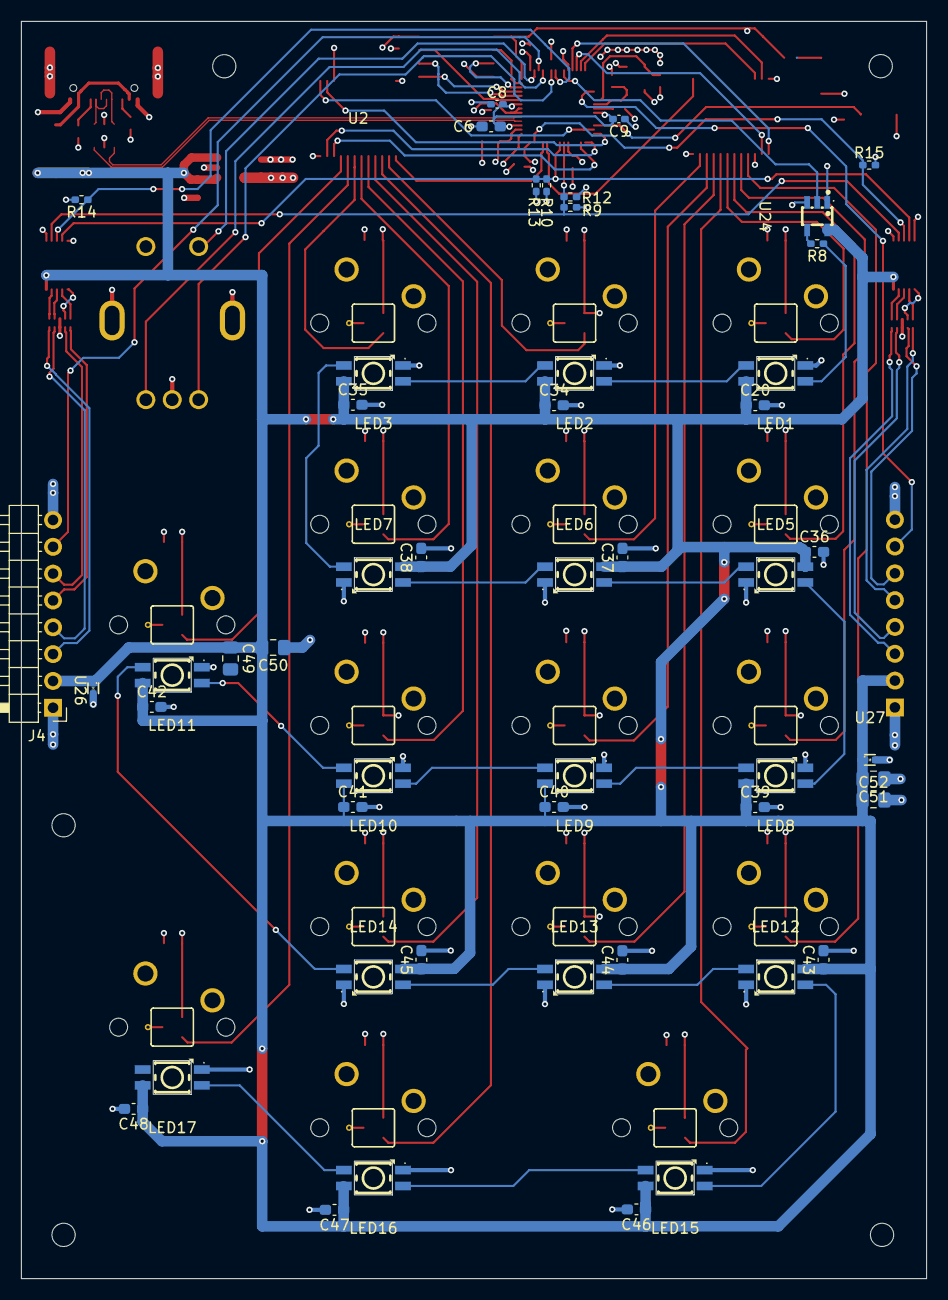
[picture p5: board Phantom Macro Mk1 Pad.kicad_pcb from below]

Board: 4 copper layers, 85.7 x 119.1 mm, 116 parts (50 on the bottom side), 89 nets.
